ceydabiber/LidarNavBot/CAD FILES/prints.jpeg

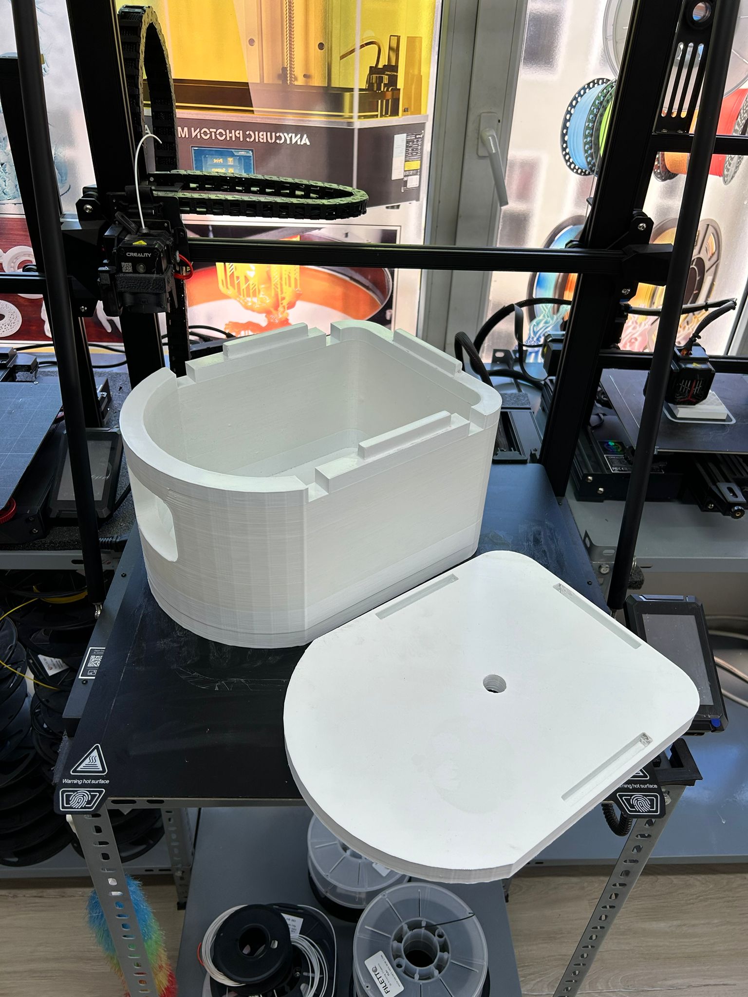
CAD FILES/prints.jpeg
