ceydabiber/LidarNavBot/Circuits/cam_to_ardunio.jpeg

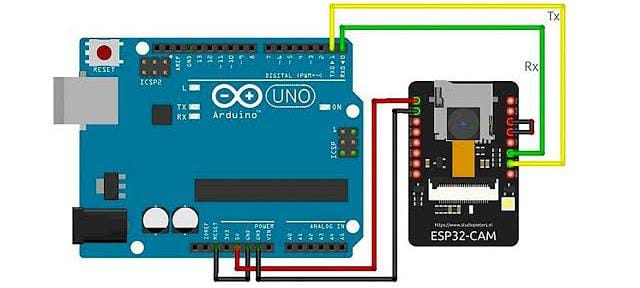
Circuits/cam_to_ardunio.jpeg
