ceydabiber/LidarNavBot/CAD FILES/STL/STLimage.jpg

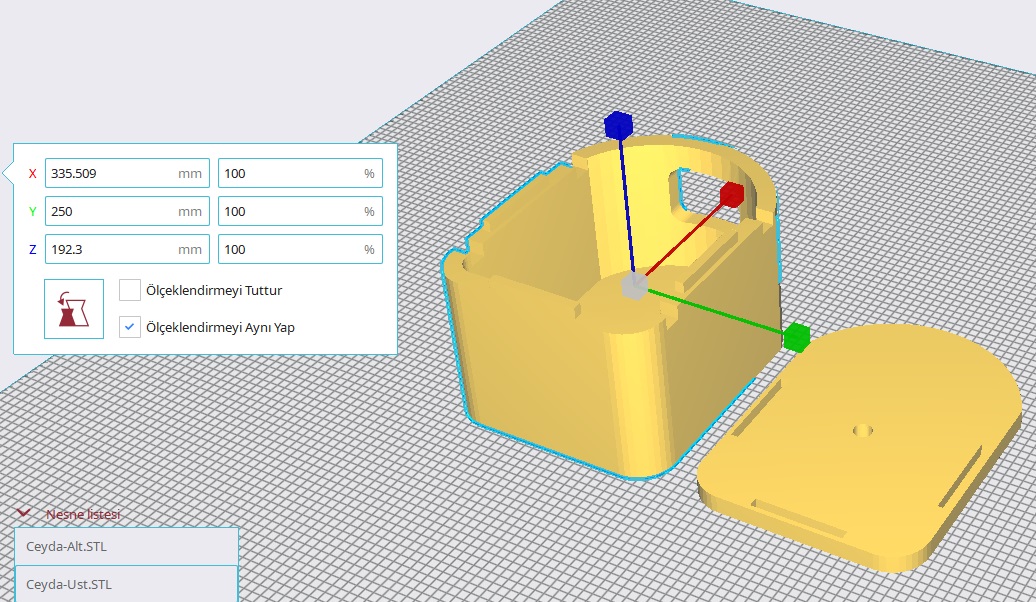
CAD FILES/STL/STLimage.jpg
