ceydabiber/LidarNavBot/Circuits/Ardunio_to_encoder_dc_motor.jpeg

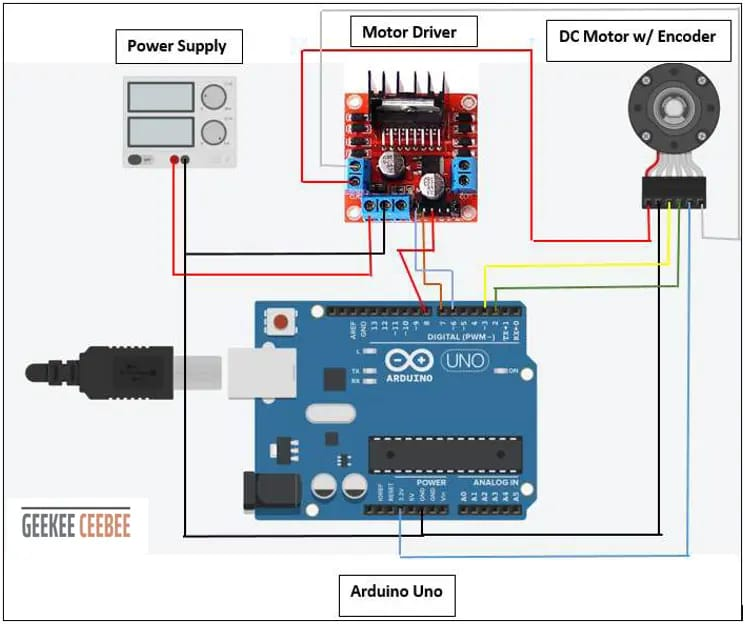
Circuits/Ardunio_to_encoder_dc_motor.jpeg
