ceydabiber/LidarNavBot/Circuits/radar_and_2motors.jpg

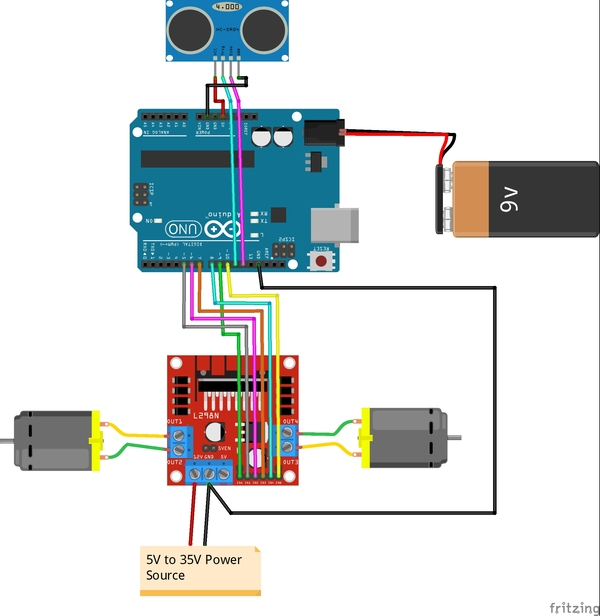
Circuits/radar_and_2motors.jpg
