ceydabiber/LidarNavBot/Circuits/Radar_and_4motors.jpeg

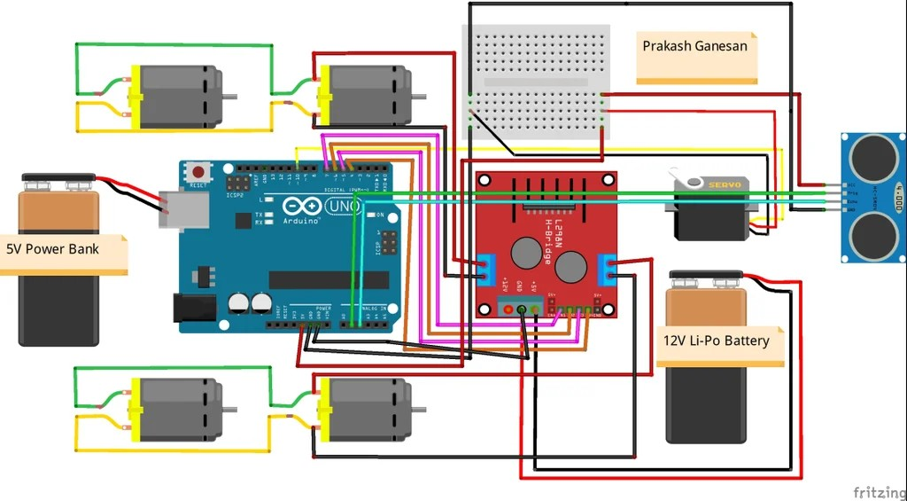
Circuits/Radar_and_4motors.jpeg
