ceydabiber/LidarNavBot/Circuits/Robots_final_circuit.jpeg

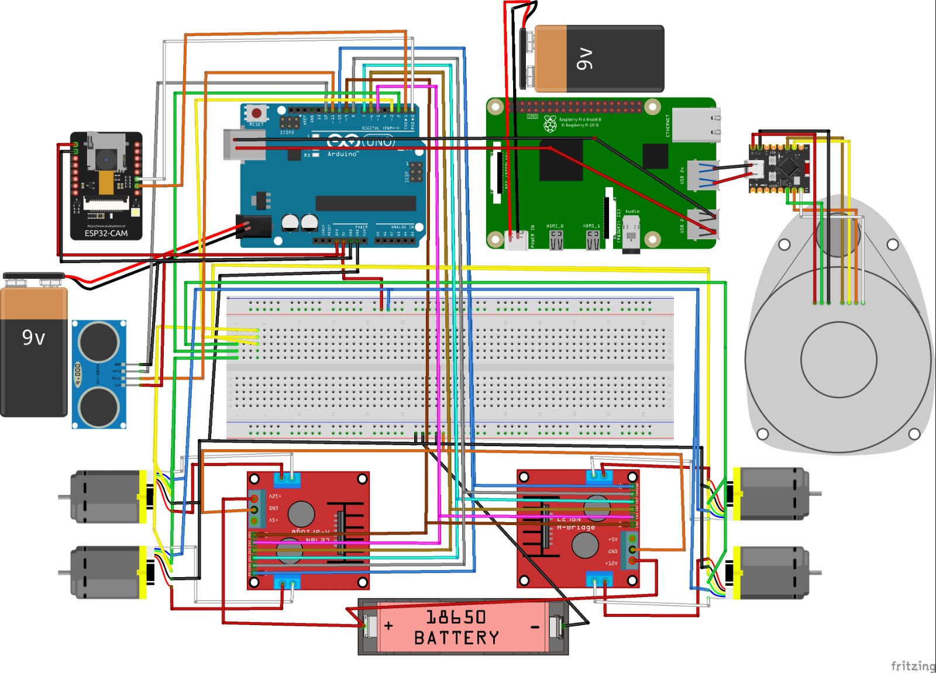
Circuits/Robots_final_circuit.jpeg
