ceydabiber/LidarNavBot/CAD FILES/SOLIDWORKS/alt_tabla.SLDPRT

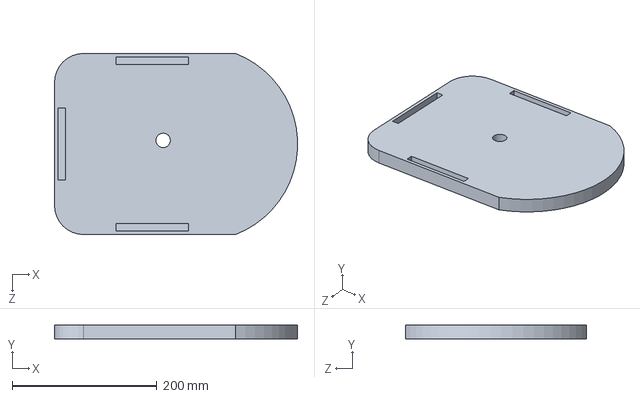
[picture p11: CAD file, 2024-09-06]
CAD FILES/SOLIDWORKS/alt_tabla.SLDPRT
335.5 x 20.0 x 250.0 mm
