ceydabiber/LidarNavBot/CAD FILES/STL/üst.STL

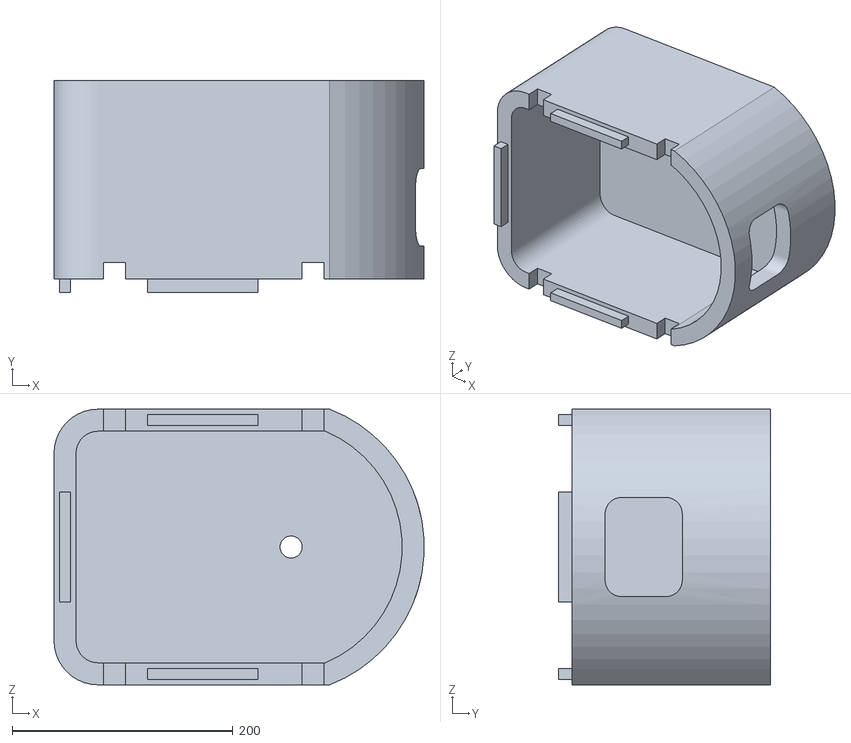
[picture p12: CAD file, 2024-09-06]
CAD FILES/STL/üst.STL
335.5 x 192.3 x 250.0
