ceydabiber/LidarNavBot/CAD FILES/SOLIDWORKS/üst_tabla.SLDPRT

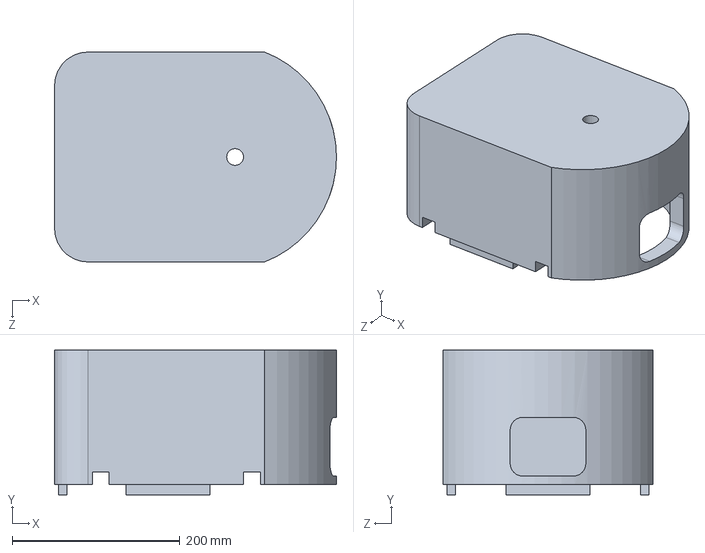
[picture p13: CAD file, 2024-09-06]
CAD FILES/SOLIDWORKS/üst_tabla.SLDPRT
335.7 x 172.3 x 250.0 mm
