ceydabiber/LidarNavBot/CAD FILES/SOLIDWORKS/motor yuva.SLDPRT

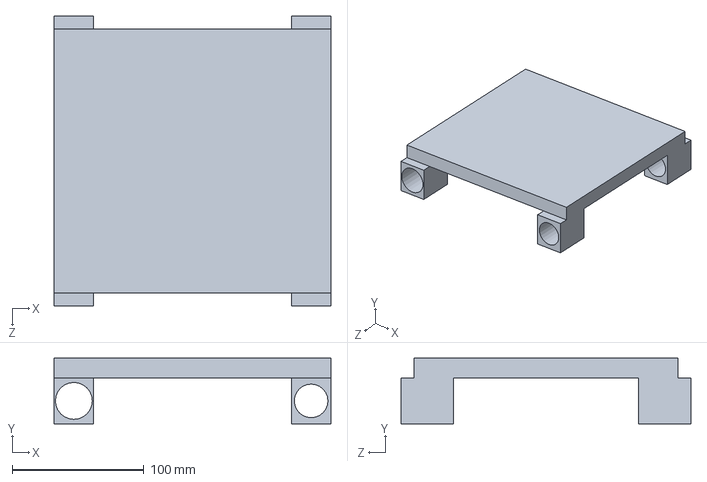
[picture p14: CAD file, 2024-09-06]
CAD FILES/SOLIDWORKS/motor yuva.SLDPRT
210.0 x 50.0 x 220.0 mm
