ceydabiber/LidarNavBot/CAD FILES/SOLIDWORKS/Montaj.SLDASM

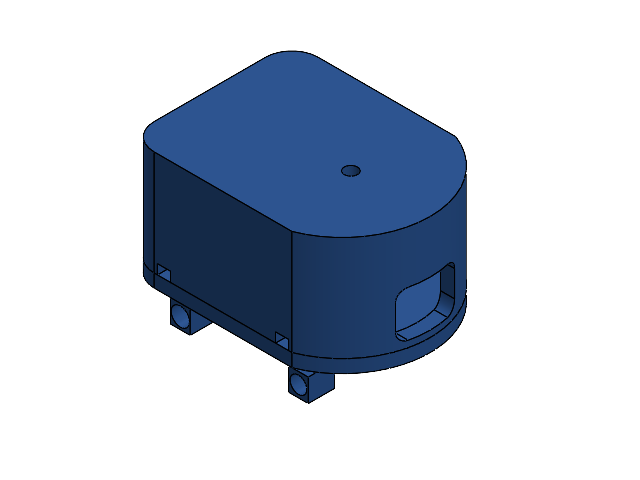
[picture p15: CAD file, 2024-09-06]
CAD FILES/SOLIDWORKS/Montaj.SLDASM
güncel
motor yuva
ü
