ceydabiber/LidarNavBot/(list of files, cad)

Other CAD files:
CAD FILES/STL/alt.STL
