ceydabiber/LidarNavBot/Differential_Drive_Robot_Gazebo/robot_four/src/robot_model_pkg/urdf/robot.xacro

<?xml version="1.0"?>
<robot name="differential_drive_robot" xmlns:xacro="http://www.ros.org/wiki/xacro">

  <xacro:property name="body_link_x_dim" value="1"/>
  <xacro:property name="body_link_y_dim" value="0.6"/>
  <xacro:property name="body_link_z_dim" value="0.3"/>

  <xacro:property name="cameraSize" value="0.05"/>
  <xacro:property name="cameraMass" value="0.1"/>


  <xacro:property name="wheel_link_radius" value="0.15"/>
  <xacro:property name="wheel_link_length" value="0.1"/>
  <xacro:property name="wheel_link_z_location" value="-0.1"/>

  <xacro:property name="body_density" value="2710.0"/>
  <xacro:property name="wheel_density" value="2710.0"/>

  <xacro:property name="pi_const" value="3.14159265"/>

  <xacro:property name="body_mass" value="${body_density * body_link_x_dim * body_link_y_dim * body_link_z_dim}"/>
  <xacro:property name="wheel_mass" value="${wheel_density * pi_const * wheel_link_radius * wheel_link_length}"/>

  <xacro:property name="Iz_wheel" value="${0.5 * wheel_mass * wheel_link_radius * wheel_link_radius}"/>
  <xacro:property name="I_wheel" value="${(1.0 / 12.0) * wheel_mass * (3.0 * wheel_link_radius * wheel_link_radius + wheel_link_length)}"/>

  <xacro:macro name="inertia_wheel">
    <inertial>
      <origin rpy="0 0 0" xyz="0 0 0"/>
      <mass value="${wheel_mass}"/>
      <inertia ixx="${I_wheel}" ixy="0.0" ixz="0.0" iyy="${I_wheel}" iyz="0" izz="${Iz_wheel}"/>
    </inertial>
  </xacro:macro>

  <xacro:include filename="$(find robot_model_pkg)/urdf/robot.gazebo"/>

  <link name="dummy"/>
  <joint name="dummy_joint" type="fixed">
    <parent link="dummy"/>
    <child link="body_link"/>
  </joint>

  <link name="body_link">
    <visual>
      <geometry>
        <box size="${body_link_x_dim} ${body_link_y_dim} ${body_link_z_dim}"/>
      </geometry>
      <origin rpy="0 0 0" xyz="0 0 0"/>
    </visual>

    <collision>
      <geometry>
        <box size="${body_link_x_dim} ${body_link_y_dim} ${body_link_z_dim}"/>
      </geometry>
      <origin rpy="0 0 0" xyz="0 0 0"/>
    </collision>

    <inertial>
      <origin rpy="0 0 0" xyz="0 0 0"/>
      <mass value="${body_mass}"/>
      <inertia ixx="${(1/12)*body_mass*(body_link_y_dim*body_link_y_dim+body_link_z_dim*body_link_z_dim)}" ixy="0" ixz="0" iyy="${(1/12)*body_mass*(body_link_x_dim*body_link_x_dim+body_link_z_dim*body_link_z_dim)}" iyz="0" izz="${(1/12)*body_mass*(body_link_y_dim*body_link_y_dim+body_link_x_dim*body_link_x_dim)}"/>
    </inertial>
  </link>

  <joint name="wheel1_joint" type="continuous">
    <parent link="body_link"/>
    <child link="wheel1_link" />
    <origin xyz="${-body_link_x_dim/2+1.2*wheel_link_radius} ${-body_link_y_dim/2-wheel_link_length/2} ${wheel_link_z_location}" rpy="0 0 0" />
    <axis xyz="0 1 0"/>
    <limit effort="1000" velocity="1000"/>
    <dynamics damping="1.0" friction="1.0"/>
  </joint>

  <link name="wheel1_link">
    <visual>
      <origin rpy="1.570795 0 0" xyz="0 0 0"/>
      <geometry>
        <cylinder length="${wheel_link_length}" radius="${wheel_link_radius}"/>
      </geometry>
    </visual>

    <collision>
      <origin rpy="1.570795 0 0" xyz="0 0 0"/>
      <geometry>
        <cylinder length="${wheel_link_length}" radius="${wheel_link_radius}"/>
      </geometry>
    </collision>

    <xacro:inertia_wheel />

  </link>

  <joint name="wheel2_joint" type="continuous">
    <parent link="body_link"/>
    <child link="wheel2_link" />
    <origin xyz="${-body_link_x_dim/2+1.2*wheel_link_radius} ${body_link_y_dim/2+wheel_link_length/2} ${wheel_link_z_location}" rpy="0 0 0" />
    <axis xyz="0 1 0"/>
    <limit effort="1000" velocity="1000"/>
    <dynamics damping="1.0" friction="1.0"/>
  </joint>
  
  <link name="wheel2_link">
    <visual>
      <origin rpy="1.570795 0 0" xyz="0 0 0"/>
      <geometry>
        <cylinder length="${wheel_link_length}" radius="${wheel_link_radius}"/>
      </geometry>
    </visual>     
         
    <collision>
      <origin rpy="1.570795 0 0" xyz="0 0 0"/>
      <geometry>
        <cylinder length="${wheel_link_length}" radius="${wheel_link_radius}"/>
      </geometry>         
    </collision>
         
    <xacro:inertia_wheel />
  </link>
  
  <joint name="wheel3_joint" type="continuous">
    <parent link="body_link"/>
    <child link="wheel3_link" />
    <origin xyz="${body_link_x_dim/2-1.2*wheel_link_radius} ${-body_link_y_dim/2-wheel_link_length/2} ${wheel_link_z_location}" rpy="0 0 0" />
    <axis xyz="0 1 0"/>
    <limit effort="1000" velocity="1000"/>
    <dynamics damping="1.0" friction="1.0"/>
  </joint>
  
  <link name="wheel3_link">
    <visual>
      <origin rpy="1.570795 0 0" xyz="0 0 0"/>
      <geometry>
        <cylinder length="${wheel_link_length}" radius="${wheel_link_radius}"/>
      </geometry>
    </visual>     
         
    <collision>
      <origin rpy="1.570795 0 0" xyz="0 0 0"/>
      <geometry>
        <cylinder length="${wheel_link_length}" radius="${wheel_link_radius}"/>
      </geometry>         
    </collision>
         
    <xacro:inertia_wheel />
  </link>  

  <joint name="wheel4_joint" type="continuous">
    <parent link="body_link"/>
    <child link="wheel4_link" />
    <origin xyz="${body_link_x_dim/2-1.2*wheel_link_radius} ${body_link_y_dim/2+wheel_link_length/2} ${wheel_link_z_location}" rpy="0 0 0" />
    <axis xyz="0 1 0"/>
    <limit effort="1000" velocity="1000"/>
    <dynamics damping="1.0" friction="1.0"/>
  </joint>
  
  <link name="wheel4_link">
    <visual>
      <origin rpy="1.570795 0 0" xyz="0 0 0"/>
      <geometry>
        <cylinder length="${wheel_link_length}" radius="${wheel_link_radius}"/>
      </geometry>
    </visual>     
         
    <collision>
      <origin rpy="1.570795 0 0" xyz="0 0 0"/>
      <geometry>
        <cylinder length="${wheel_link_length}" radius="${wheel_link_radius}"/>
      </geometry>         
    </collision>
         
    <xacro:inertia_wheel />
  </link>

  <link name="camera_link">
    <collision>
      <origin xyz="0 0 0" rpy="0 0 0"/>
      <geometry>
        <box size="${cameraSize} ${cameraSize} ${cameraSize}"/>
      </geometry>
    </collision>

    <visual>
      <origin xyz="0 0 0" rpy="0 0 0"/>
      <geometry>
        <box size="${cameraSize} ${cameraSize} ${cameraSize}"/>
      </geometry>
      <material name="green">
        <color rgba="0 1 0 1"/> <!-- Green color with full opacity -->
      </material>
    </visual>

    <inertial>
      <mass value="${cameraMass}" />
      <origin xyz="0 0 0" rpy="0 0 0"/>
      <box_inertia m="${cameraMass}" x="${cameraSize}" y="${cameraSize}" z="${cameraSize}" />
      <inertia ixx="1e-6" ixy="0" ixz="0" iyy="1e-6" iyz="0" izz="1e-6" />
    </inertial>
  </link>

  <joint name="camera_joint" type="fixed">
    <axis xyz="0 1 0" />
    <origin xyz="0.5 0 0" rpy="0 0 0"/>
    <parent link="body_link"/>
    <child link="camera_link"/>
  </joint>

  <!-- Define 2D lidar sensor -->
  <link name="laser_frame">
    <visual>
      <geometry>
        <cylinder radius="0.05" length="0.04"/>
      </geometry>
      <material name="red"/>
    </visual>
    <collision>
      <geometry>
        <cylinder radius="0.05" length="0.04"/>
      </geometry>
    </collision>
    <inertial>
      <mass value="0.1"/>
      <origin xyz="0 0 0" rpy="0 0 0"/>
      <inertia ixx="1e-6" ixy="0" ixz="0" iyy="1e-6" iyz="0" izz="1e-6" />
    </inertial>
  </link>

  <joint name="laser_joint" type="fixed">
    <parent link="body_link"/>
    <child link="laser_frame"/>
    <origin xyz="0.1 0 0.175" rpy="0 0 0"/>
  </joint>


</robot>
