ceydabiber/LidarNavBot/Results/7th_floor_dorm.jpeg

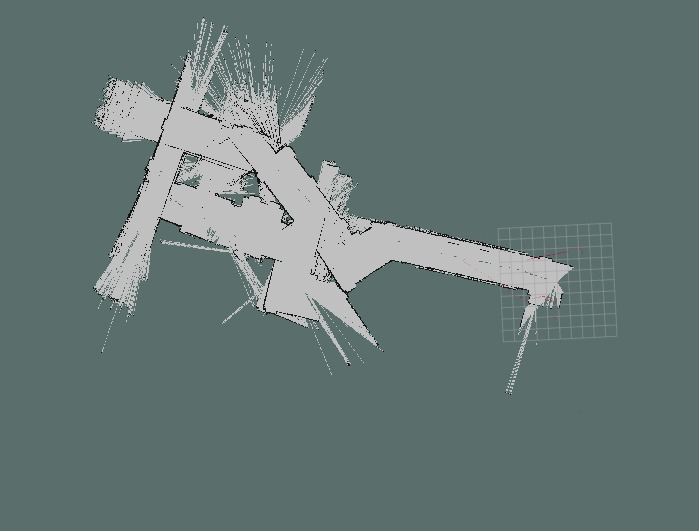
Results/7th_floor_dorm.jpeg
