ceydabiber/LidarNavBot/Results/Dorm_room.jpeg

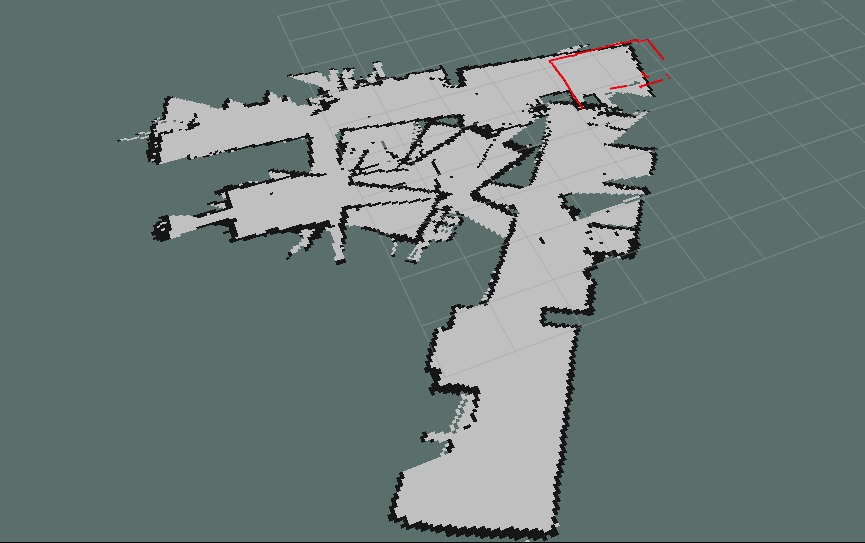
Results/Dorm_room.jpeg
