ceydabiber/LidarNavBot/Results/House_plan2.jpeg

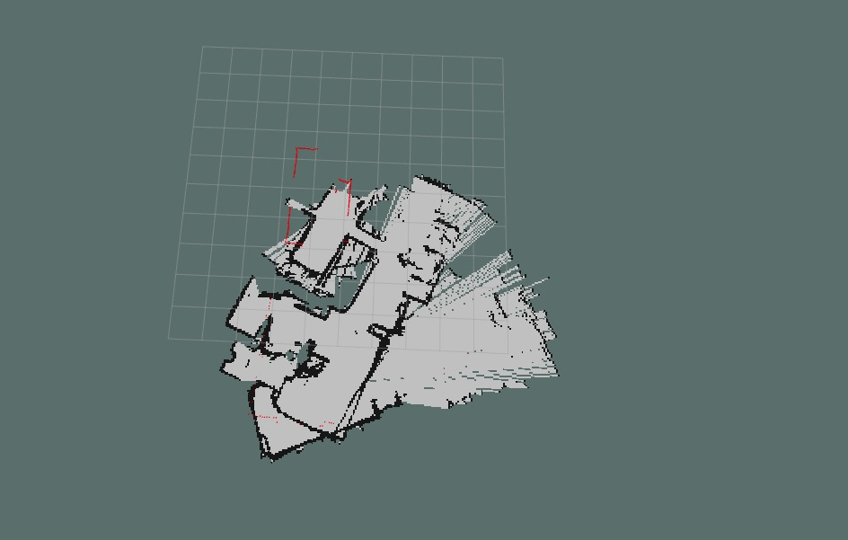
Results/House_plan2.jpeg
