ceydabiber/LidarNavBot/Results/House_plan.jpeg

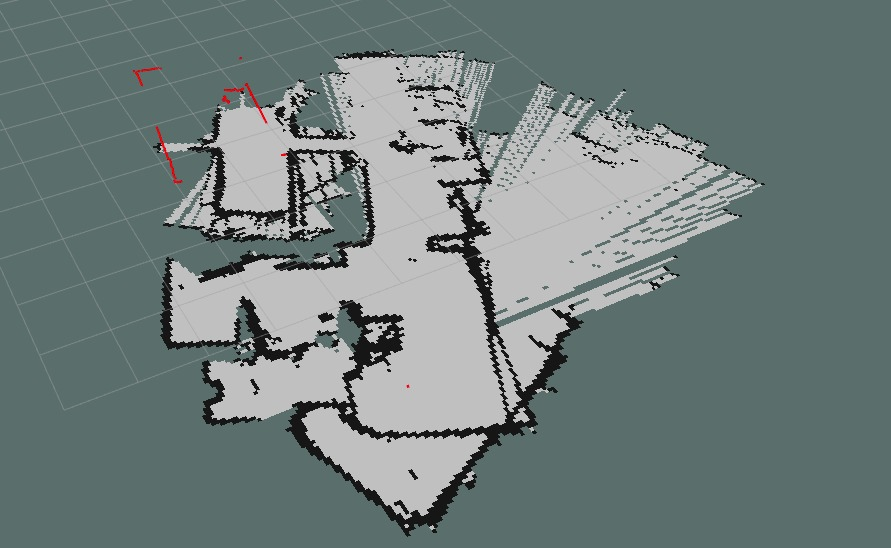
Results/House_plan.jpeg
