ceydabiber/LidarNavBot/Results/Open_field_test.jpeg

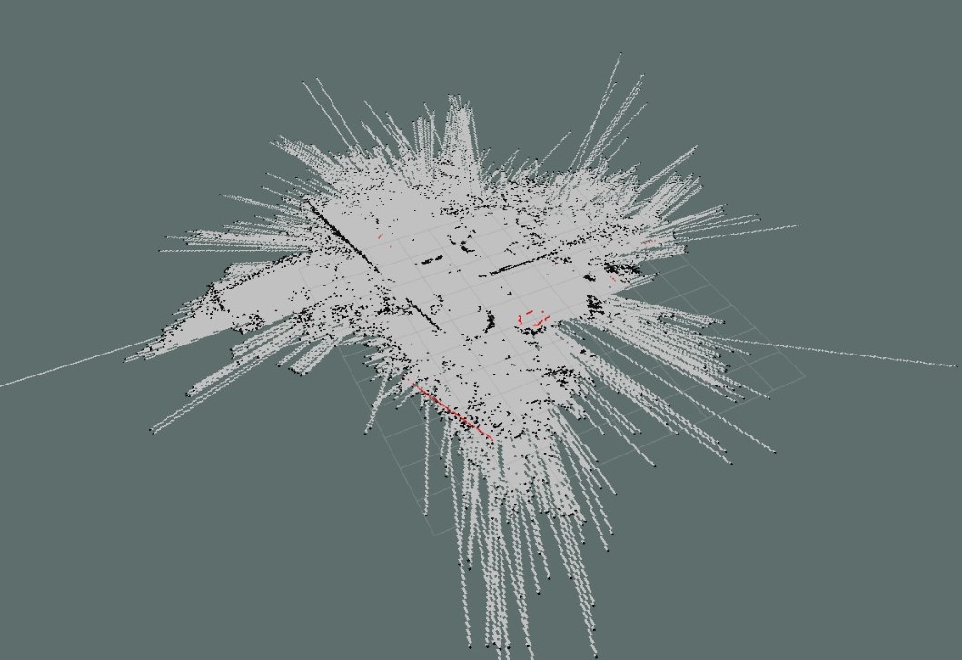
Results/Open_field_test.jpeg
