ceydabiber/LidarNavBot/Obstacle Avoidance/Obstacle_avoidance_with_fixed_radar/Obstacle_avoidance_with_fixed_radar.ino

// Motor A connections
const int enA = 9;
const int in1 = 5;
const int in2 = 6;
 
// Motor B connections
const int enB = 10;
const int in3 = 7;
const int in4 = 8;
 
// Set the speed (0 = off and 255 = max speed)
// If your wheels are not moving, check your connections, or increase the speed.
const int motorSpeed = 80;

#define Trigger 11
#define Echo 12
  

void setup(){
    
  //Serial.begin(9600);
  
  // Motor control pins are outputs
  pinMode(enA, OUTPUT);
  pinMode(enB, OUTPUT);
  pinMode(in1, OUTPUT);
  pinMode(in2, OUTPUT);
  pinMode(in3, OUTPUT);
  pinMode(in4, OUTPUT);
 
  // Turn off motors - Initial state
  digitalWrite(in1, LOW);
  digitalWrite(in2, LOW);
  digitalWrite(in3, LOW);
  digitalWrite(in4, LOW);
 
  // Set the motor speed
  analogWrite(enA, motorSpeed); 
  analogWrite(enB, motorSpeed); 
  
  // Define each pin as an input or output.
  pinMode(Echo, INPUT);
  pinMode(Trigger, OUTPUT);
  
  // Initializes the pseudo-random number generator
  // Needed for the robot to wander around the room
  randomSeed(analogRead(3));
  
  delay(200);     // Pause 200 milliseconds               
  go_forward();   // Go forward
}
  
void loop(){
  int distance = doPing();
  
  // If obstacle <= 40 cm away
  if (distance >= 0 && distance <= 40) {  
       
    //Serial.println("Obstacle detected ahead");  
    go_backwards();   // Move in reverse
    delay(2000);
  
    /* Go left or right to avoid the obstacle*/
    if (random(2) == 0) {  // Generates 0 or 1, randomly        
      go_right();  // Turn right
    }
    else {
      go_left();  // Turn left
    }
    delay(3000);
    go_forward();  // Move forward
  }
  delay(50); // Wait 50 milliseconds before pinging again
}
  
/*  Returns the distance to the obstacle as an integer */

int doPing () {
  int distance = 0;
  int average = 0;
  
  for (int i = 0; i < 4; i++) {
  
    // Make the Trigger LOW (0 volts) 
    // for 2 microseconds
    digitalWrite(Trigger, LOW);
    delayMicroseconds(2);
  
      
    // Emit high frequency 40kHz sound pulse by making Trigger HIGH (5 volts) for 10 microseconds
    
    digitalWrite(Trigger, HIGH);
    delayMicroseconds(10);
    digitalWrite(Trigger, LOW);
       
    // Detect a pulse on the Echo pin 8. 
    // pulseIn() measures the time in microseconds until the sound pulse returns back to the sensor.
    distance = pulseIn(Echo, HIGH);
  
    // Speed of sound is: 34300 cm per second,  34.3 cm per millisecond,  0.0343 cm per microsecond.
    // Taking the reciprocal, we have: 29.1545 microseconds per centimeter
    // Convert microseconds to centimeters by dividing by 29.1545 and then dividing by 2 to account for the roundtrip time.
    distance = distance / 29.1545 / 2;
  
    // Compute running sum
    average += distance;
  
    // Wait 10 milliseconds between pings
    delay(10);
  }
  
  // Return the average of the four distance 
  // measurements
  return (average / 4);
}
  
/*   
 *  Forwards, backwards, right, left, stop.
 */
void go_forward() {
  digitalWrite(in1, HIGH);
  digitalWrite(in2, LOW);
  digitalWrite(in3, HIGH);
  digitalWrite(in4, LOW);
}
void go_backwards() {
  digitalWrite(in1, LOW);
  digitalWrite(in2, HIGH);
  digitalWrite(in3, LOW);
  digitalWrite(in4, HIGH);
}
void go_right() {
  digitalWrite(in1, HIGH);
  digitalWrite(in2, LOW);
  digitalWrite(in3, LOW);
  digitalWrite(in4, HIGH);
}
void go_left() {
  digitalWrite(in1, LOW);
  digitalWrite(in2, HIGH);
  digitalWrite(in3, HIGH);
  digitalWrite(in4, LOW);
}
void stop_all() {
  digitalWrite(in1, LOW);
  digitalWrite(in2, LOW);
  digitalWrite(in3, LOW);
  digitalWrite(in4, LOW);
}
